nic6911/Nilan_Homeassistant/electronics/20210906_175947768_iOS.jpg

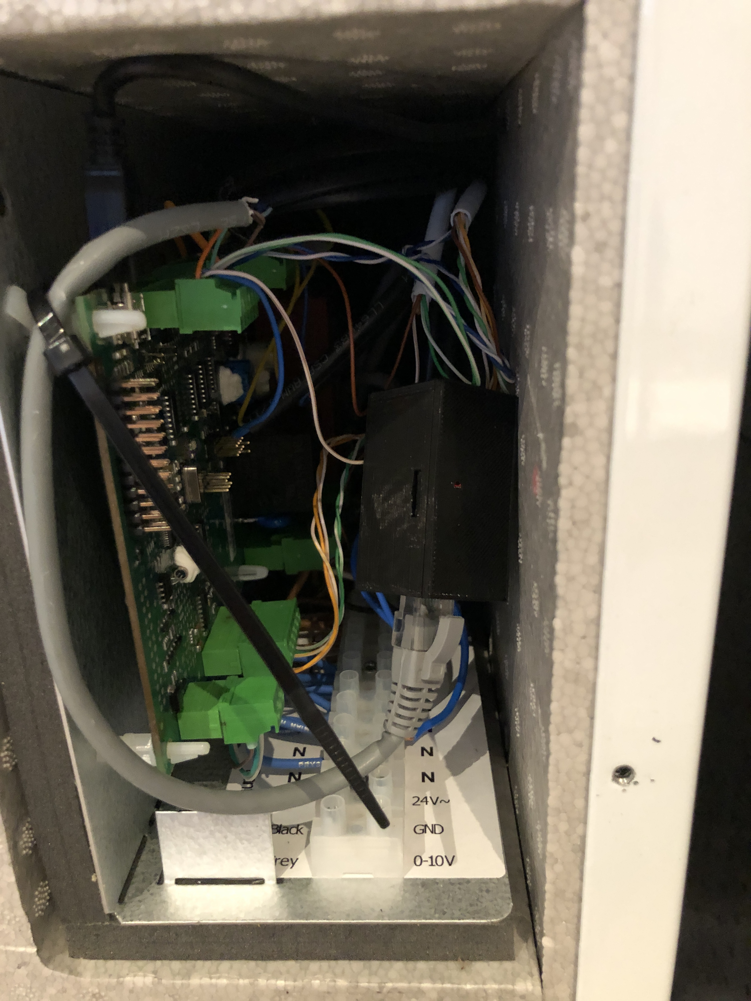
electronics/20210906_175947768_iOS.jpg
