nic6911/Nilan_Homeassistant/electronics/programmer1.JPG

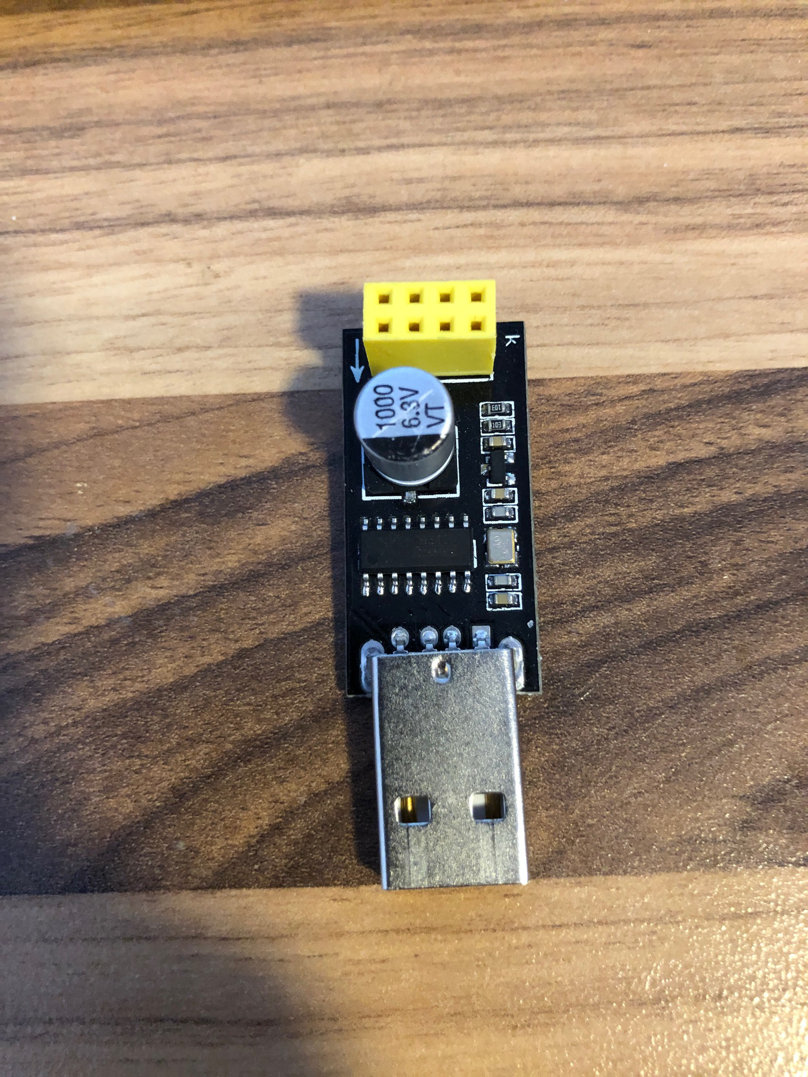
electronics/programmer1.JPG
