nic6911/Nilan_Homeassistant/electronics/programmer2.JPG

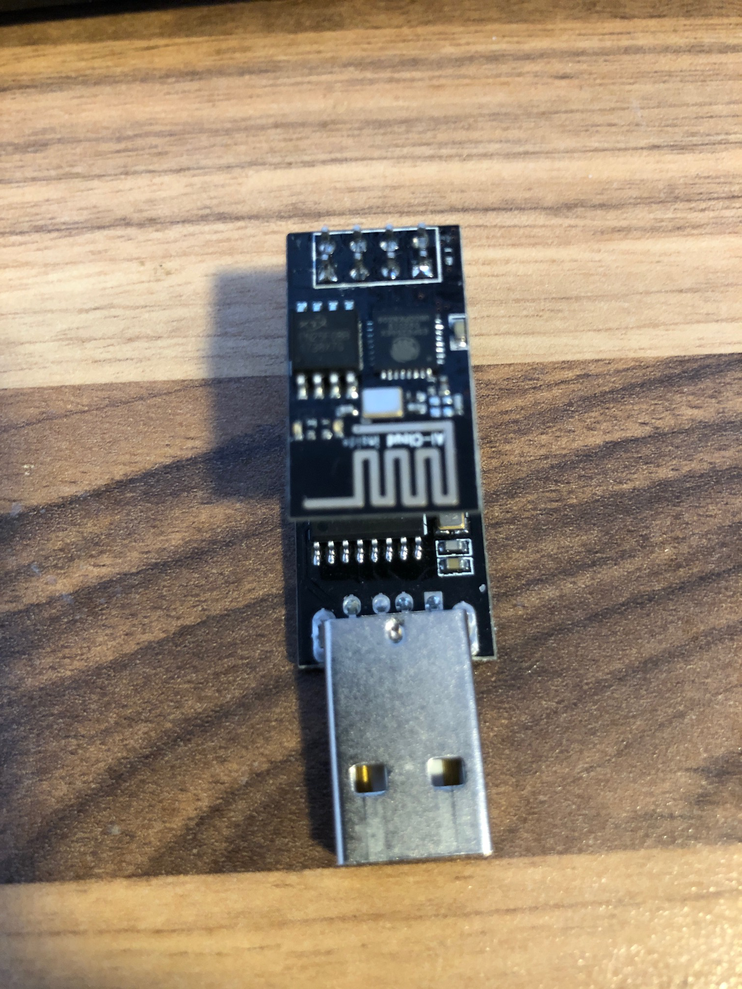
electronics/programmer2.JPG
