nic6911/Nilan_Homeassistant/electronics/programmer3.JPG

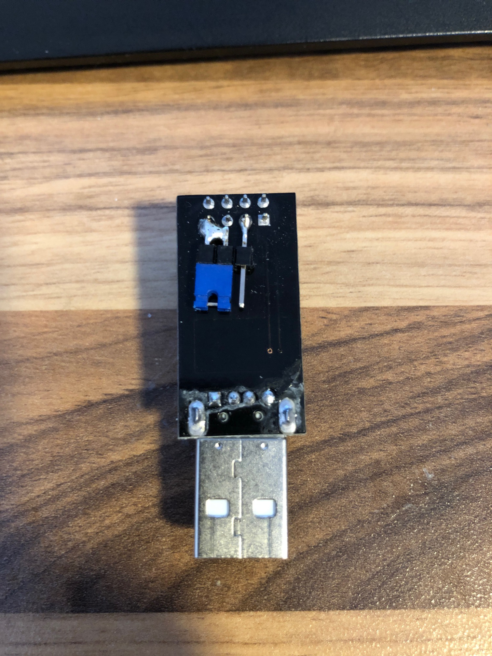
electronics/programmer3.JPG
