nic6911/Nilan_Homeassistant/electronics/programmer4.JPG

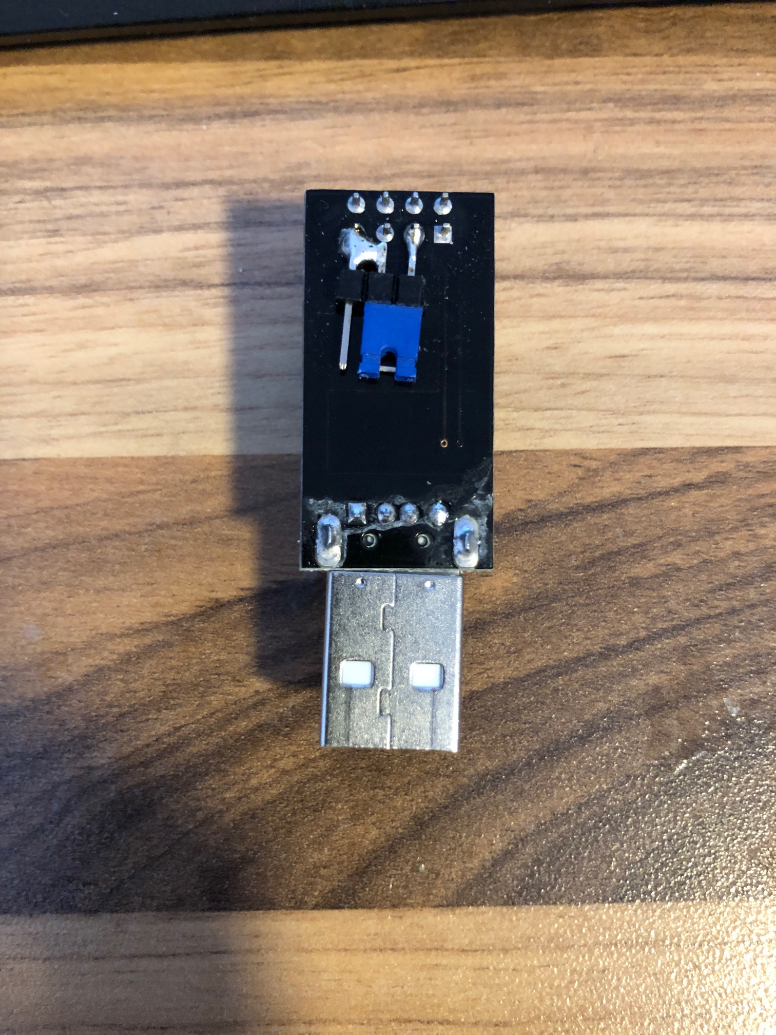
electronics/programmer4.JPG
