nic6911/Nilan_Homeassistant/Esphome/lovelace.PNG

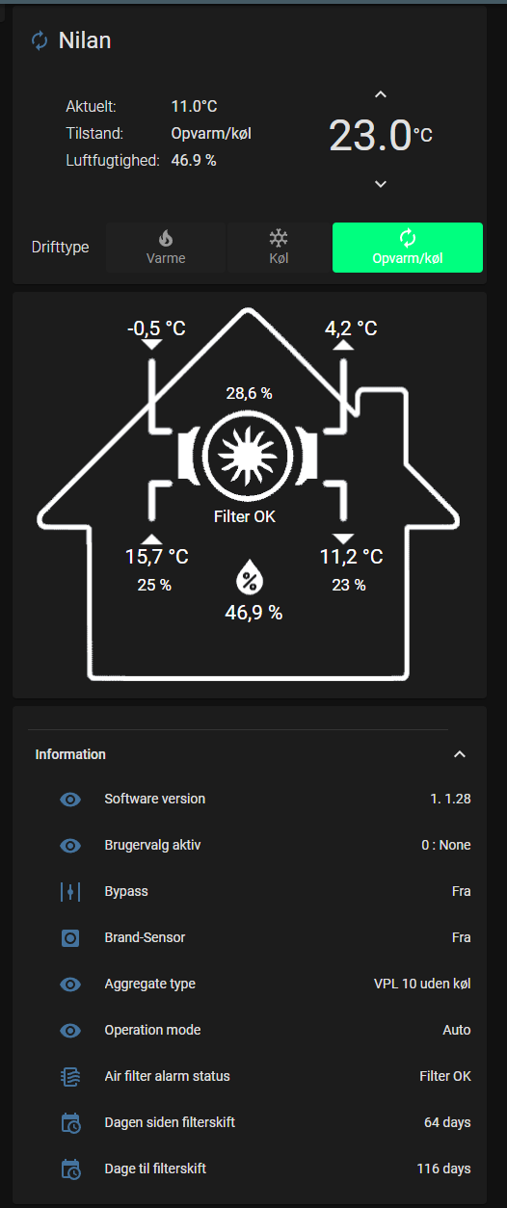
Esphome/lovelace.PNG
