nic6911/Nilan_Homeassistant/Esphome/ventilation.png

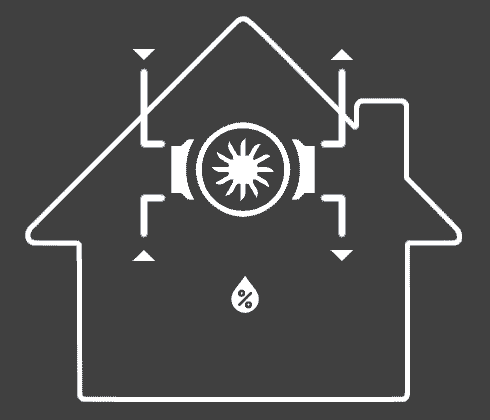
Esphome/ventilation.png
