nic6911/Nilan_Homeassistant/casing/Lid.stl

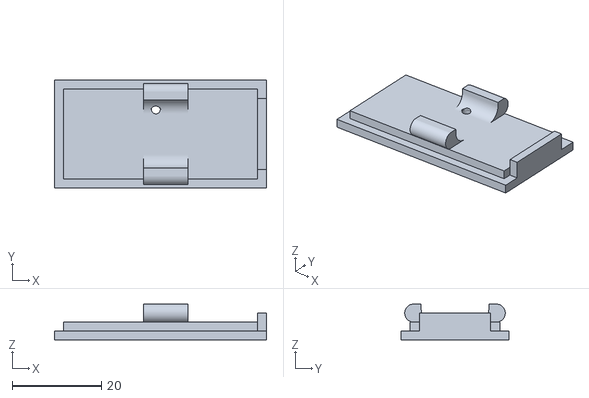
[picture p17: CAD file, 2021-04-13]
casing/Lid.stl
47.5 x 24.3 x 8.00
