nic6911/Nilan_Homeassistant/casing/Case.stl

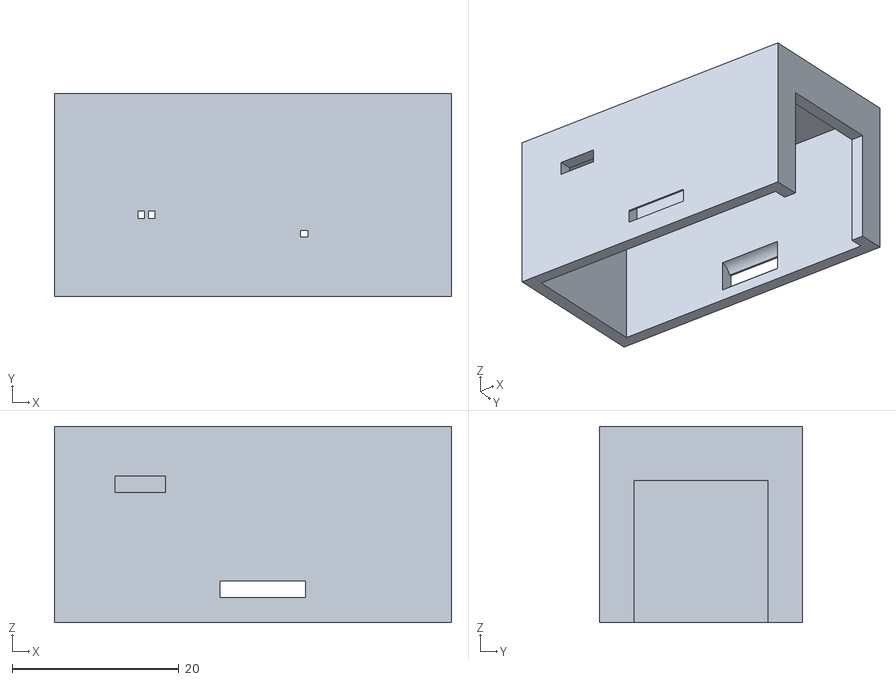
[picture p18: CAD file, 2021-04-13]
casing/Case.stl
47.5 x 24.3 x 23.5
