nic6911/Nilan_Homeassistant/Esphome/installation.png

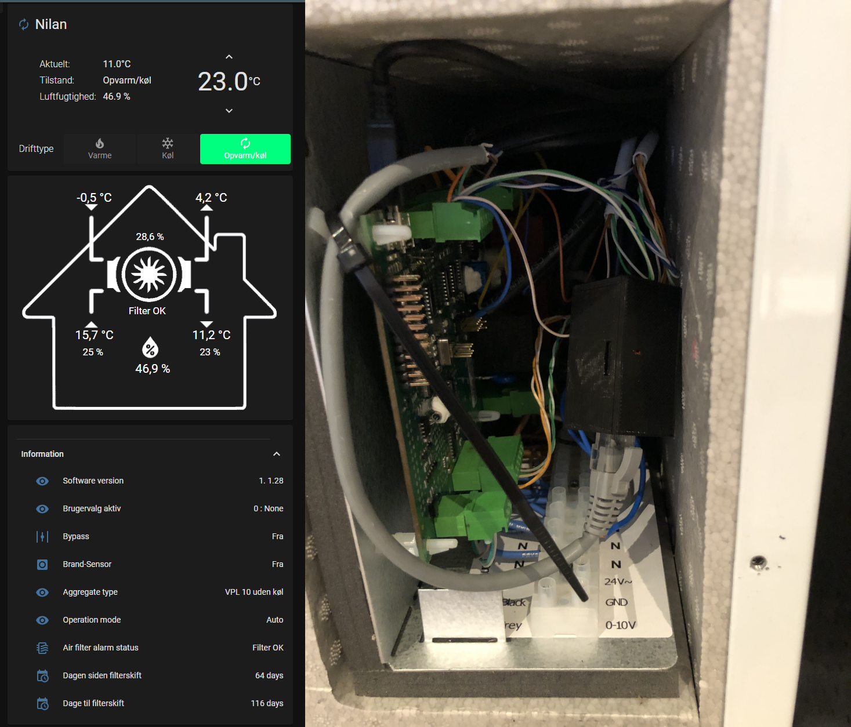
Esphome/installation.png
