nic6911/Nilan_Homeassistant/nilan_code/configuration.h

/* 
 *  It should not be necessary to change anything else than in this file to suit your needs.
 *  If you need to change other things, consider adding to this file and submit a pull request :)
 *  Remember that all password, ssid´s and so on are CASE SENSITIVE !
 */

#define CUSTOM_HOSTNAME "NilanGW-%s"  // Host name of the ESP8266 so that it's easier to find in your DHCP range

// MQTT settings
#define MQTTSERVER   "192.168.0.100" // Put in the IP adresse of your MQTT broker
#define MQTTUSERNAME "user" // User name for the MQTT broker (NULL if no user name is required)
#define MQTTPASSWORD "pass" // Password for the MQTT broker (NULL if no password is required)
