nic6911/Nilan_Homeassistant/(commit log)

2021-04-13 My contribution added
    [Case.stl, Lid.stl, configuration.h]
2021-04-14 Trying out feature for OTA when no Wifi
    [configuration.h]
2021-11-08 SW update with wifi manager
    [configuration.h]
2022-01-15 correction to esphome
    brugervalg 1+2 tilføjet m. switches til styring af optokoblere
    [nilan.yaml]
2022-01-16 esphome code updated again
    Fixed the error of writing to the nilan. Now it works !
    [nilan.yaml]
2022-07-09 updated schematics
